Anastien/UGSIM-M/05-BOM/Sim800.xls

Name | Description | Designator | Quantity | Manufacturer | Manufacturer Part Number | Supplier | Supplier Part Number | Supplier Unit Price | Supplier Subtotal
CONUFL001 | CONN UMC JACK STR SMD | ANT1 | 1 | Linx | CONUFL001-SMD-T | Mouser | 712-CONUFL001-SMD-T | 0.62 | 0.62
100uF | Tantalum Capacitor | C1 | 1 | KEMET | TAJD107K010RNJ | LCSC | C7222 | 1.29 | 0.20303
1uF | 1µF Molded Tantalum Capacitors 35V 1206 (3216 Metric) 7.5Ohm @ 100kHz | C2 | 1 | Kyocera AVX | TAJA105K035TNJ | Mouser | 581-TAJA105K035TNJ | 0.41 | 0.41
10Pf | Multilayer Ceramic Capacitors MLCC - SMD/SMT 16V 10pF 0603 X7R 0.1 | C3 | 1 | KEMET | C0603C100K4RACTU | Mouser | 80-C0603C100K4RACTU | 0.24 | 0.24
33pF | Multilayer Ceramic Capacitors MLCC - SMD/SMT 50V 33pF 0603 X8R 20% | C4 | 1 | KEMET | C0603C330M5HACTU | Mouser | 80-C0603C330M5HACTU | 0.1 | 0.1
0.1uF | Cap Ceramic 0.1uF 50V X7R 5% SMD 0603 125C Paper T/R. CC0603JPX7R9BB104 | C5 | 1 | Yageo | CC0603JPX7R9BB104 | Mouser | 603-CC0603JPX79BB104 | 0.13 | 0.13
4.7uF | CAP TANT 4.7UF 10% 16V 1206,TAJA475K016RNJ | C6 | 1 | Kyocera AVX | TAJA475K016RNJ | Mouser | 581-TAJA475K016R | 0.41 | 0.41
MMSZ5231BT1G | DIODE ZENER 5.1V 500MW SOD123 | D1 | 1 | ON Semiconductor | MMSZ5231BT1G | Mouser | 863-MMSZ5231BT1G | 0.2 | 0.2
SMF12CT1G | TVS DIODE 12V 23V SC88 | D2 | 1 | ON Semiconductor | SMF12CT1G | Mouser | 863-SMF12CT1G | 0.46 | 0.46
SMC-202-6 | SMC-202-6 | J1 | 1 | XUNPU | SMC-202-6 | LCSC | C266634 | 0.484848 | 0.484848
Green | LED GREEN DIFFUSED 0603 SMD | LD1 | 1 | Rohm | SML-D12M8WT86 | Digi-Key | 511-1578-1-ND | 0.33 | 0.33
Yellow | LED YELLOW DIFFUSED 0603 SMD | LD2 | 1 | Rohm | SML-D12Y8WT86 | Mouser | 755-SML-D12Y8WT86 | 0.32 | 0.32
DTC143ZU3HZGT106 |  | Q1, Q2, Q3, Q4 | 4 | Rohm | DTC143ZU3HZGT106 | Mouser | 755-DTC143ZU3HZGT106 | 0.32 | 1.28
10kohms |  | R1 | 1 | Panasonic | ERJ-3EKF1002V | Digi-Key | P10.0KHDKR-ND | 0.1 | 0.1
75 Ohm |  | R2, R3 | 2 | Rohm | ESR03EZPJ131 | Mouser | 755-ESR03EZPJ131 | 0.1 | 0.2
10kOhm | RES SMD 10K OHM 1% 1/4W 0603 | R4 | 1 | Rohm | ESR03EZPF1002 | Mouser | 755-ESR03EZPF1002 | 0.12 | 0.12
20kOhm | RES SMD 10K OHM 1% 1/4W 0603 | R5 | 1 | Rohm | ESR03EZPF1002 | Mouser | 755-ESR03EZPF1002 | 0.12 | 0.12
SIM800 | complete Quad-band GSM/GPRS solution in a SMT type which can be embedded in the customer applications. | U1 | 1 | Simcom | SIM800 | LCSC | C90688 | 5.334848 | 5.334848
 |  |  |  |  |  |  |  |  | 10.374848
