Anastien/UGSIM-M/01-UGSIM-M Design Files/Sim800.pdf

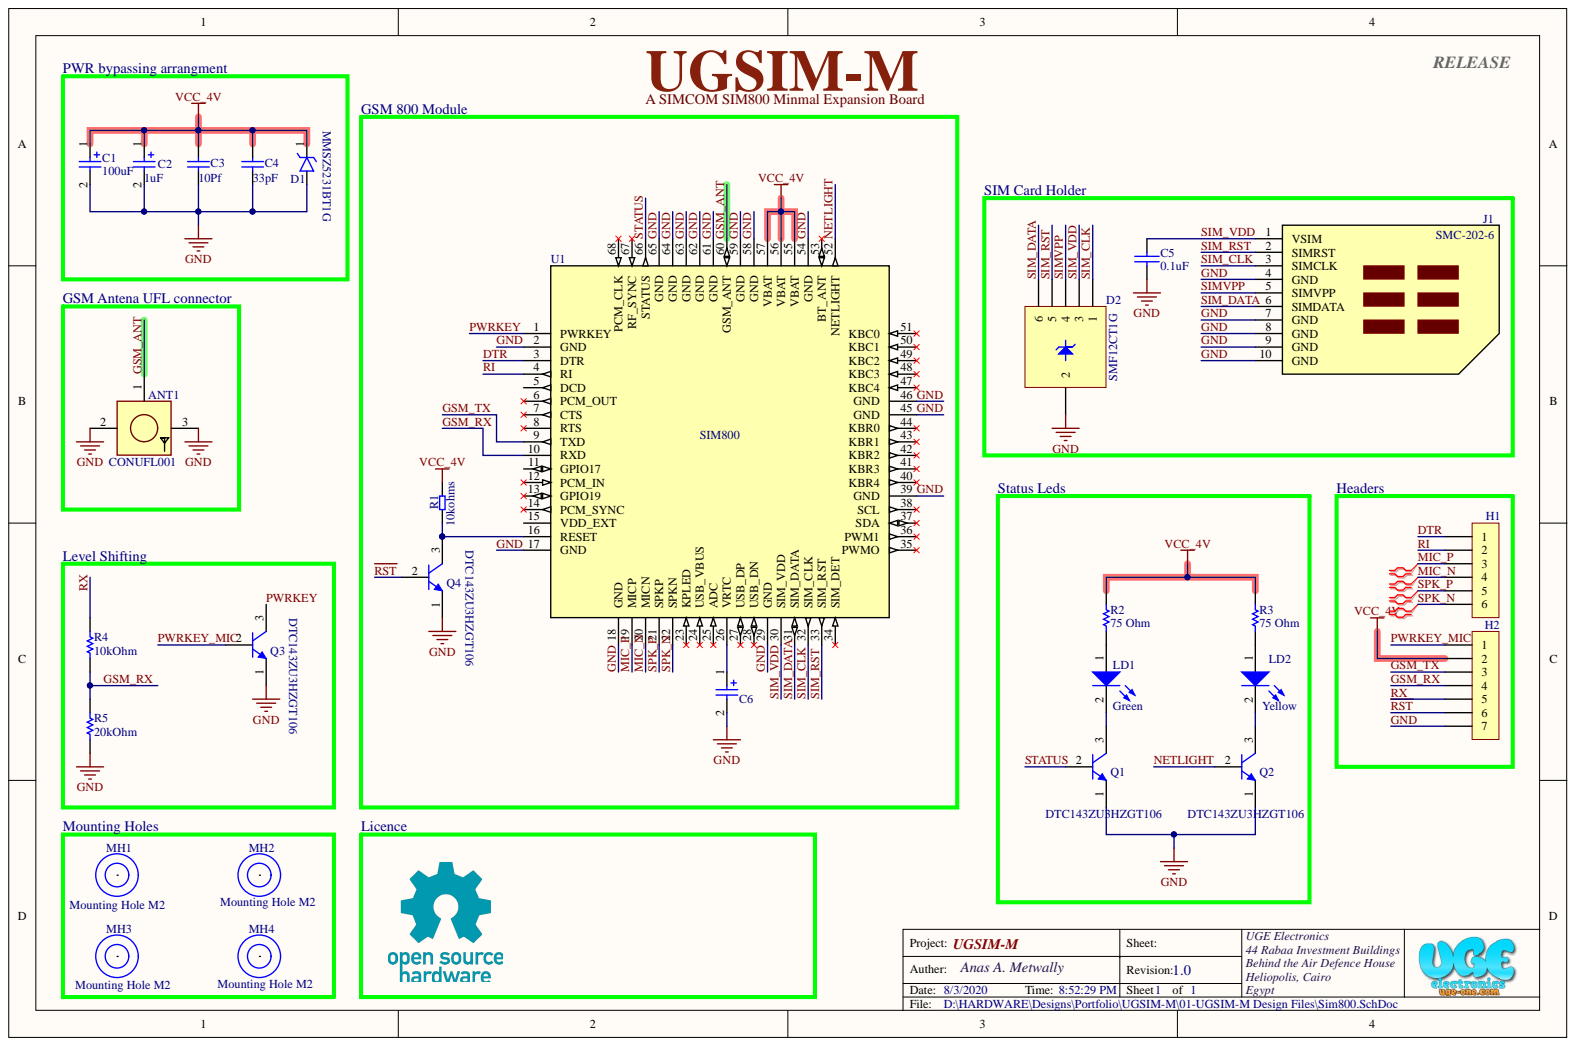
[picture p1: page 1]

A SIMCOM SIM800 Minmal Expansion Board

DET 34 PWMO 35 PWM1 36 SDA 37 SCL 38 GND 39 KBR4 40 KBR3 41 KBR2 42 KBR1 43 KBR0 44 GND 45 GND 46 KBC4 47 KBC3 48 KBC2 49 KBC1 50 NETLIGHT 52 BT_ANT 53 GND 54 VBAT 55 VBAT 56 VBAT 57 GND 58 GND 59 GSM_ANT 60 GND 61 GND 62 GND 63 GND 64 GND 65 STATUS 66 RF_SYNC 67 PCM_CLK 68

GSM Antena UFL connector

GSM_RX | 8

RXD 10

Project: UGSIM-M | Sheet: | UGE Electronics 44 Rabaa Investment Buildings Behind the Air Defence House Heliopolis, Cair o Egypt

Auther: Anas A. Metwally | 1.0 Revision:

Date: 8/3/2020 Time: 8:52:29 PM | Sheet 1 of 1
File: D:\HARDWARE\Designs\Portfolio\UGSIM-M\01-UGSIM-M Design Files\Sim800.SchDoc
