Anastien/UGSIM-M/(list of files, drawings)

Other design files:
01-UGSIM-M Design Files/sim800.PcbLib
01-UGSIM-M Design Files/Sim800.PrjPcb
01-UGSIM-M Design Files/Sim800.SchDoc
01-UGSIM-M Design Files/Sim800board.SchLib
